todateman/Chibi-T_ChassisDyno/docs/images/dyno_schematic.png

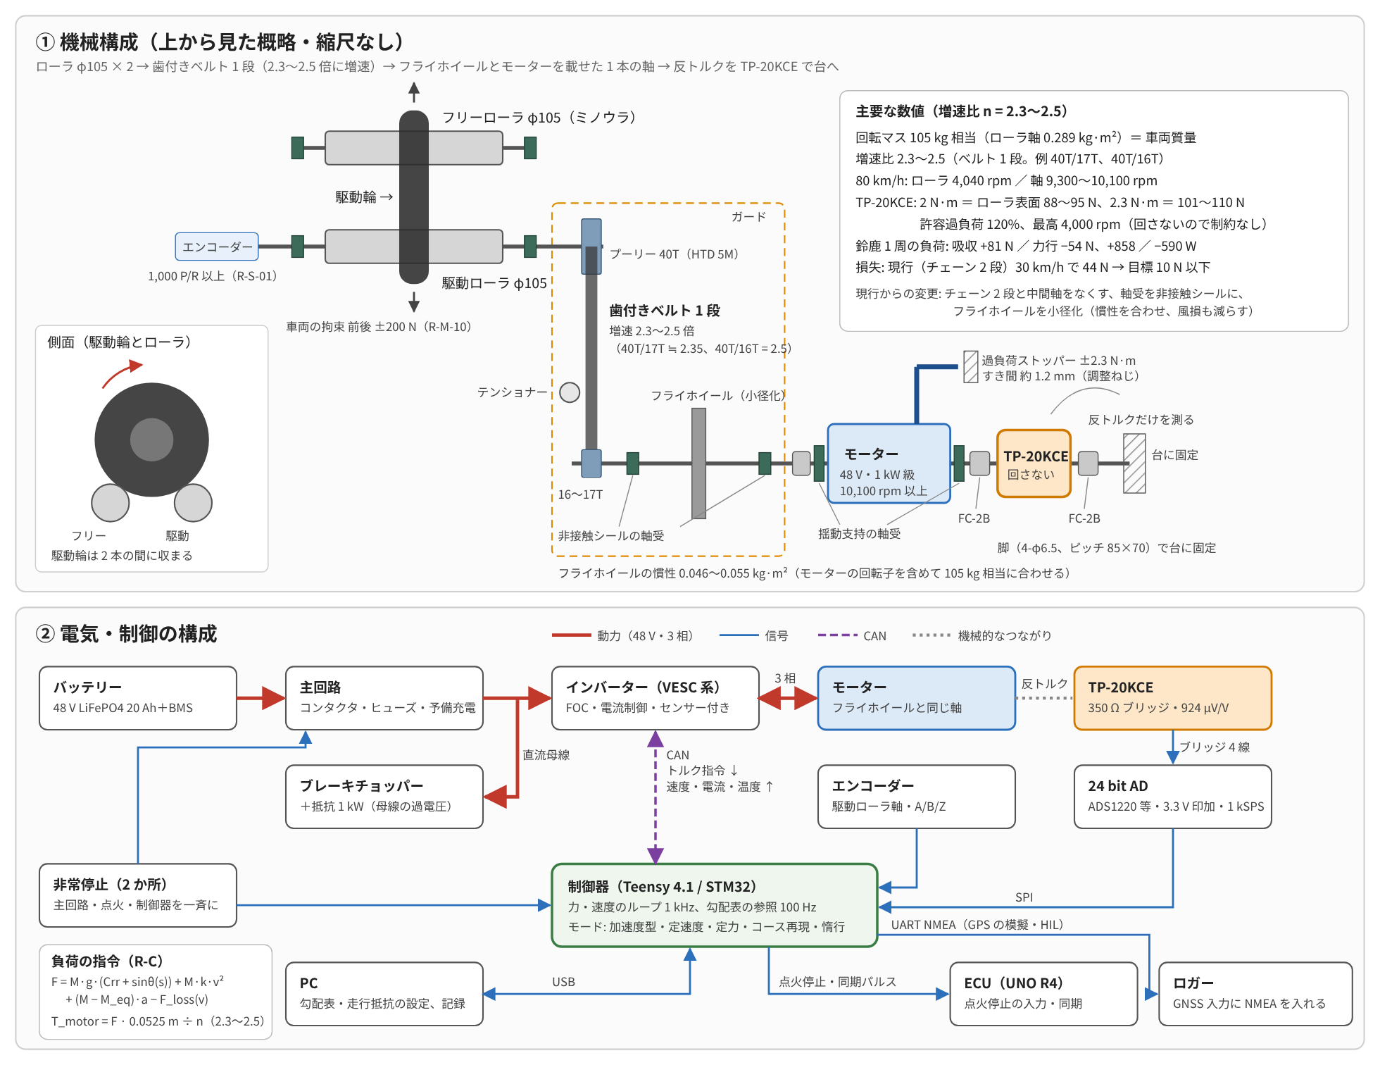
docs/images/dyno_schematic.png
