todateman/Chibi-T_ChassisDyno/(commit log)

2026-11-08 負荷付きシャシーダイナモの設計資料を追加
    - docs/requirements.md: 要件定義（機械・電気・計測・制御・安全、校正・受け入れ試験、部品例、概算予算）
    - docs/analysis_notes.md: 根拠になった解析（実走の出力推定、現行ダイナモの損失、鈴鹿の勾配、1 周の負荷）
    - docs/references.md: AkiRacing の加速度型ダイナモの要約ほか参考資料
    - analysis/: 出力推定・ダイナモログ解析・鈴鹿の負荷プロファイルのスクリプト
    - data/: 元ログ（LOG0672, LOG0650）、鈴鹿東コースのウェイポイント、計算結果
    - config/: UNOR4_Chibi-T_EFI の鈴鹿戦略パラメータ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
    [LOG0650.CSV, LOG0672_出力トルク推定.xlsx, LOG0672_燃料消費量燃費補正済.CSV, power_curve_LOG0672.csv, suzuka_east_grade_1m.csv, suzuka_east_waypoint.csv, suzuka_lap_load_dry.csv, suzuka_lap_load_dry_with_loss.csv]
2026-11-08 トルクセンサ TP-20KCE の使用検討を追加し、現行ダイナモの寸法を訂正
    - docs/torque_sensor_TP-20KCE.md: 容量と回転数の関係、取付方法の比較（反力型を推奨、増速約 2.5 倍）、
    過負荷ストッパー、計測回路、分銅での校正、小倉クラッチ OPC 20 の評価
    - 現行ダイナモをミノウラのローラ φ105・チェーン 40:19 に訂正（φ80・3 倍は AkiRacing の記事の値だった）
    - 要件定義: 力のセンサを TP-20KCE に変更（R-S-02, R-M-08, R-M-09, R-E-04 ほか）、部品表と予算を更新
    （推奨構成 約 115 万円 → 約 100 万円）、現行ダイナモの写真を追加
    Co-Autho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
2026-11-08 TP-20KCE の検討を取扱説明書の仕様とチェーン構成で更新
    - 取扱説明書（TP-D/E、IM-T-142f）と外形図（DXF）を docs/vendor に追加し、外形図を画像化
    - 仕様を反映: 最高 4,000 rpm、許容過負荷 120%、推奨印加電圧 1〜4 V、ねじればね定数 153.8 N·m/rad、
    ブラシ寿命（3,000 rpm で 50〜60 時間）、寸法（軸 φ8、本体 φ80、取付穴 4-φ6.5 ピッチ 85×70）
    - 結論を更新: 反力型でモーターをフライホイール軸（40:19）に同軸、ストッパー 2.3 N·m。
    足りなければ 2.5 倍に増速
    - 現行ダイナモ: ローラ φ105 × 2 本（1 本フリー）、チェーン 2 段（19・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
2026-11-08 検討中の構成の概略図を追加
    - docs/images/dyno_schematic.svg / .png: 機械構成（上から見た配置、側面の挿入図、主要な数値）と
    電気・制御のブロック図（動力・信号・CAN・HIL、負荷の指令の式）
    - README と要件定義の冒頭から参照
    Claude-Session: https://claude.ai/code/session_01QPKghYFdbur7XXNwidjvYs
2026-11-08 スプロケットの歯数を実物に合わせて修正
    ローラ 40T → 中間軸 19T（40:19 = 2.105 倍）、中間軸 42T → フライホイール 42T（1:1）。
    全体の増速比 2.105 倍は変わらないため、数値の計算はそのまま。概略図・要件定義・
    TP-20KCE の検討資料の歯数の表記と「要確認」を更新。
    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
2026-11-09 ローラ径と増速比の比較を追加し、φ105 流用・ベルト 1 段の案に要件を更新
    - docs/roller_diameter_and_ratio.md: φ250×3 との比較（T·ω = F·v でセンサ・モーター・
    フライホイールの条件は増速比で同じにできる）、ローラ径で変わること、損失の内訳の見込み、
    推奨する変更（歯付きベルト 1 段で 2.3〜2.5 倍、チェーン 2 段と中間軸をなくす）
    - 要件定義: R-M-02（φ105 流用）、R-M-09（ベルト 1 段 2.3〜2.5 倍）、R-E-04、損失の項を更新
    Claude-Session: https://claude.ai/code/session_01QPKghYFdbur7XXNwidjv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
2026-11-09 概略図をベルト 1 段の案に描き直し
    ローラ φ105 → 歯付きベルト 1 段（2.3〜2.5 倍、例 40T/17T・40T/16T）→ フライホイールと
    モーターを載せた 1 本の軸。チェーン 2 段と中間軸を削除し、非接触シールの軸受、小径化した
    フライホイール、テンショナーを追記。主要な数値と負荷の指令の式も増速比 n = 2.3〜2.5 で更新。
    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
